paolo-projects/rowerplus-stm32/Core/Src/main.c

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
/* Includes ------------------------------------------------------------------*/
#include "main.h"

 I2C_HandleTypeDef hi2c1;

TIM_HandleTypeDef htim1;

UART_HandleTypeDef huart2;

/* USER CODE BEGIN PV */
hall_parser_t hall_parser;
storage_data_t storage_data;

out_data_t out_data ={
		.bt = {'B', 'T', 0, 0},
		.energy = 0.0f,
		.mean_power = 0.0f,
		.distance = 0.0f,
		.checksum = 0,
		.pd = {0,0},
		.et = {'E', 'T', 0, 0},
};

BOOL hallIntermittentFlag = FALSE;
/* USER CODE END PV */

void SystemClock_Config(void);
static void MX_GPIO_Init(void);
static void MX_USART2_UART_Init(void);
static void MX_TIM1_Init(void);
static void MX_I2C1_Init(void);
/* USER CODE BEGIN PFP */
void ergometer_stroke(ergometer_stroke_params_t* stroke_params);
void params_received(damping_constants_t* damping_constants);
/* USER CODE END PFP */

/**
  * @brief  The application entry point.
  * @retval int
  */
int main(void)
{
  /* MCU Configuration--------------------------------------------------------*/

  /* Reset of all peripherals, Initializes the Flash interface and the Systick. */
  HAL_Init();

  /* Configure the system clock */
  SystemClock_Config();

  /* Initialize all configured peripherals */
  MX_GPIO_Init();
  MX_USART2_UART_Init();
  MX_TIM1_Init();
  MX_I2C1_Init();
  /* USER CODE BEGIN 2 */
	hall_parser_init();
	memset(&hall_parser, 0, sizeof(hall_parser_t));

	// We check if we have the parameters stored inside the EEPROM
	// If that's the case, we use them straight away
	if(storage_read(&storage_data))
	{
		hall_parser.damping_constants.ka = storage_data.ka;
		hall_parser.damping_constants.km = storage_data.km;
		hall_parser.damping_constants.ks = storage_data.ks;
		hall_parser.damping_constants.has_params = TRUE;
	}

	hall_parser.callback = ergometer_stroke;
	hall_parser.damping_params_callback = params_received;
	hall_parser.params.I = MOMENT_OF_INERTIA;

	HAL_TIM_Base_Start_IT(&htim1);
  /* USER CODE END 2 */

  /* Infinite loop */
  /* USER CODE BEGIN WHILE */
  while (1)
  {
    /* USER CODE END WHILE */

    /* USER CODE BEGIN 3 */
  }
  /* USER CODE END 3 */
}

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
/* USER CODE BEGIN 4 */
void ergometer_stroke(ergometer_stroke_params_t* stroke_params)
{
#ifdef DEBUG_STROKE_PARAMS
	char buffer[32];
	sprintf(buffer, "%.3f,%.3f,%.3f\r\n", stroke_params->energy, stroke_params->mean_power, stroke_params->distance);
	HAL_UART_Transmit(&huart2, buffer, strlen(buffer), 100);
#else
	out_data.energy = stroke_params->energy_kcal;
	out_data.mean_power = stroke_params->mean_power;
	out_data.distance = stroke_params->distance;
	out_data.checksum = 0;

	for(uint8_t* it = (uint8_t*)&out_data; it < (uint8_t*)&out_data + sizeof(out_data_t); it++)
	{
		if(it != (uint8_t*)&out_data.checksum && it != (uint8_t*)&out_data.checksum + 1)
		{
			out_data.checksum += *it;
		}
	}

	HAL_UART_Transmit(&huart2, (uint8_t*)&out_data, sizeof(out_data_t), 100);
#endif
}

void params_received(damping_constants_t* damping_constants)
{
	// Every time we compute new valid parameters we save them into the EEPROM
	storage_data.ka = damping_constants->ka;
	storage_data.km = damping_constants->km;
	storage_data.ks = damping_constants->ks;
	storage_write(&storage_data);
}

void HAL_GPIO_EXTI_Callback(uint16_t GPIO_Pin)
{
	if(GPIO_Pin == HALL_Pin)
	{
		hall_parser_push_trigger(&hall_parser);
	}
}

/* USER CODE END 4 */
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
