paolo-projects/rowerplus-stm32/Core/Inc/main.h

#define HALL_Pin GPIO_PIN_0
#define HALL_GPIO_Port GPIOA
#define HALL_EXTI_IRQn EXTI0_IRQn
#define USART_TX_Pin GPIO_PIN_2
#define USART_TX_GPIO_Port GPIOA
#define USART_RX_Pin GPIO_PIN_3
#define USART_RX_GPIO_Port GPIOA
#define LD2_Pin GPIO_PIN_5
#define LD2_GPIO_Port GPIOA
