paolo-projects/rowerplus-stm32/Core/Inc/common.h

/*
 * common.h
 *
 *  Created on: May 14, 2022
 *      Author: infan
 */

#ifndef INC_COMMON_H_
#define INC_COMMON_H_



#ifndef NULL
#define NULL 0
#endif

#ifndef BOOL
#define BOOL unsigned char
#endif

#ifndef TRUE
#define TRUE 1
#endif

#ifndef FALSE
#define FALSE 0
#endif


#endif /* INC_COMMON_H_ */
