paolo-projects/rowerplus-stm32/Core/Inc/fpu_math.h

/*
 * fpu_math.h
 *
 *  Created on: May 10, 2022
 *      Author: infan
 */

#ifndef INC_FPU_MATH_H_
#define INC_FPU_MATH_H_

#define ARM_MATH_CM4

#include <stm32f401xe.h>
#include <arm_math.h>

#endif /* INC_FPU_MATH_H_ */
