paolo-projects/rowerplus-stm32/(commit log)

2022-05-17 fixed the distance calculation, added EEPROM to store damping constants when mcu is shut off
    [RowerPlusFirmware.ioc, common.h, config.h, data_storage.c, data_storage.h, ehd_math.c, ehd_math.h, fpu_math.h]
2022-05-24 reimplemented usb hid. now working. WinUSB driver is needed for windows
2022-05-24 implemented hall switch parser through the fixed-size vector implementation. TO BE TESTED and DEBUGGED
    [hall_parser.c, hall_parser.h]
2022-05-25 maybe everything works... but had to switch back to uart
2022-05-25 fixed calories calculation and distance calculation
    [hall_parser.c, main.c]
2022-05-26 more fixes to math and moment of inertia
    [config.h, hall_parser.c, hall_parser.h, main.c, main.h]
